Grouchy-Lawn-Chair/holomatrix-px/public/hardware/emt/head-23.5-assembled.stl

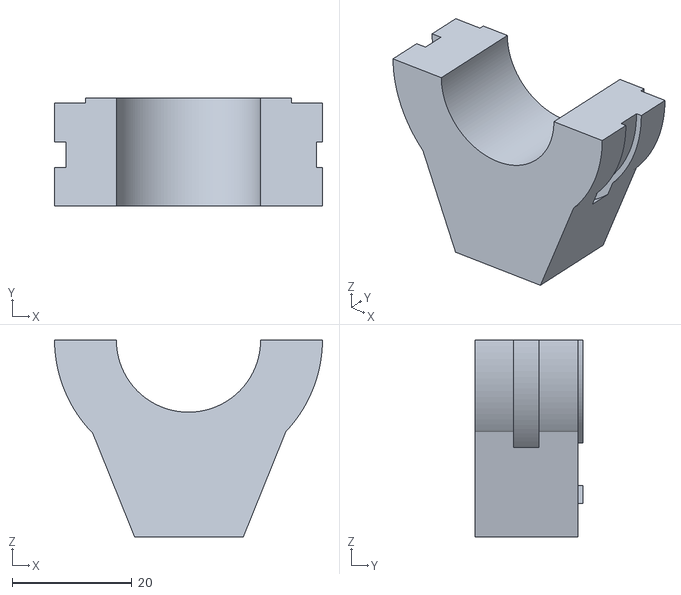
[picture p1: CAD file, 2026-10-11]
public/hardware/emt/head-23.5-assembled.stl
44.8 x 18.1 x 32.9
