Grouchy-Lawn-Chair/holomatrix-px/public/hardware/emt/base-assembled.stl

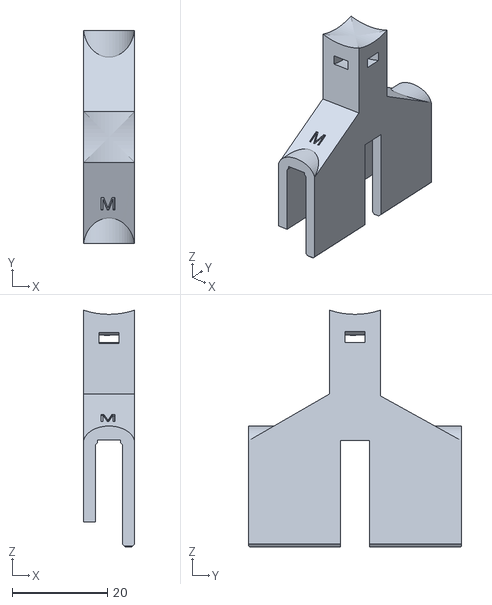
[picture p2: CAD file, 2026-10-11]
public/hardware/emt/base-assembled.stl
10.8 x 44.7 x 49.8
