Grouchy-Lawn-Chair/holomatrix-px/public/hardware/emt/head-21.336-assembled.stl

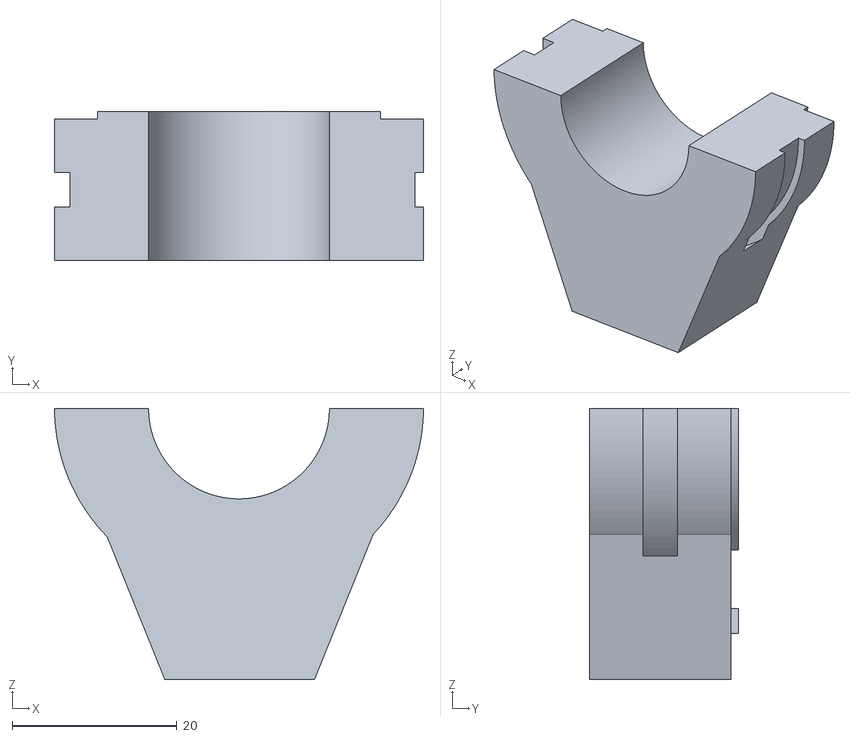
[picture p3: CAD file, 2026-10-11]
public/hardware/emt/head-21.336-assembled.stl
44.8 x 18.1 x 32.9
