Grouchy-Lawn-Chair/holomatrix-px/diffuser_references/pvc_house_clip.stl

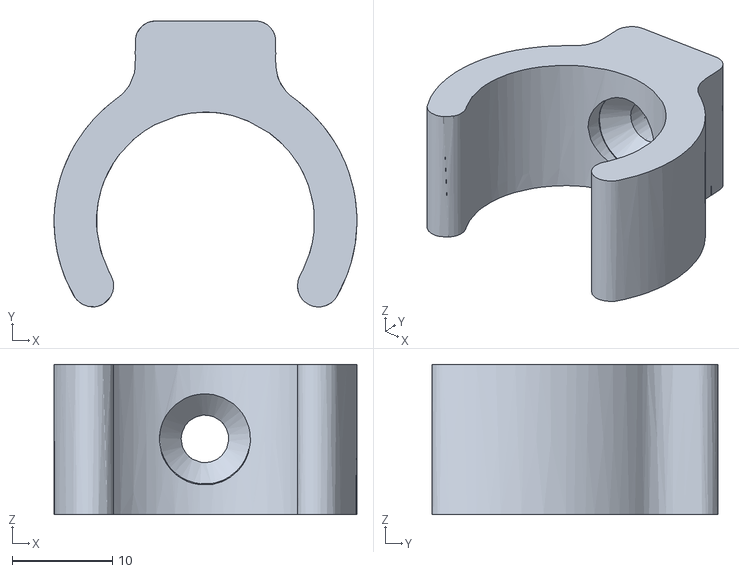
[picture p4: CAD file, 2026-10-11]
diffuser_references/pvc_house_clip.stl
30.2 x 28.5 x 15.0
