Grouchy-Lawn-Chair/holomatrix-px/diffuser_references/house_33mm.stl

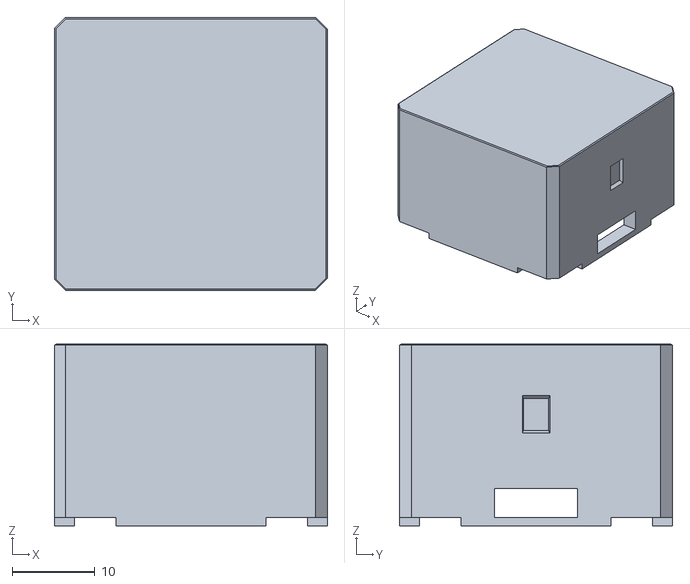
[picture p5: CAD file, 2026-10-11]
diffuser_references/house_33mm.stl
33.0 x 33.0 x 22.0
