Grouchy-Lawn-Chair/holomatrix-px/diffuser_references/mario_25_08mm.stl

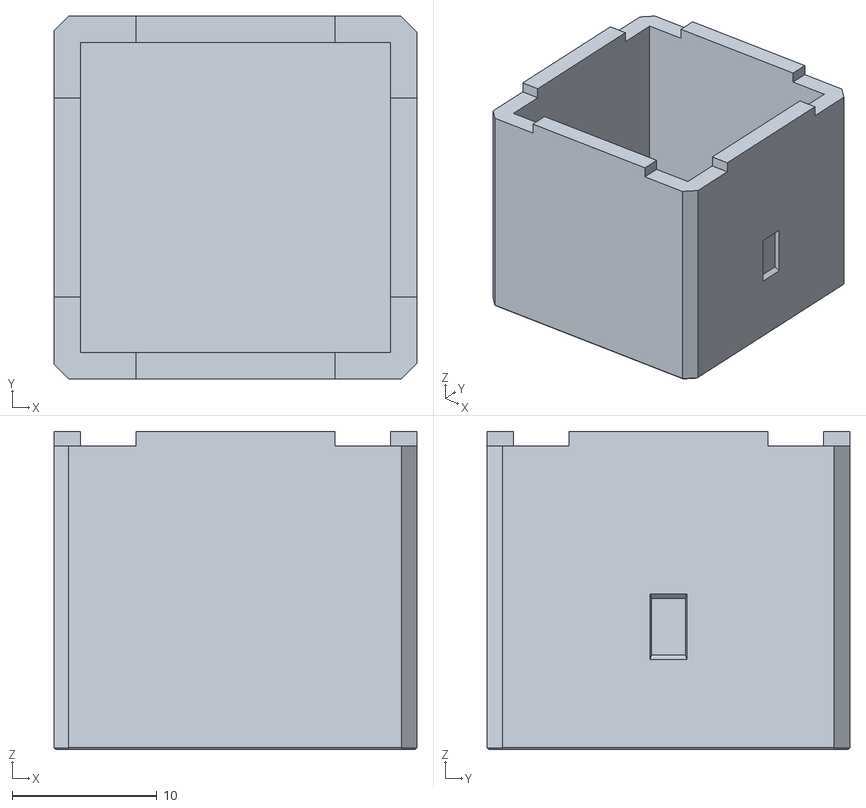
[picture p6: CAD file, 2026-10-11]
diffuser_references/mario_25_08mm.stl
25.1 x 25.1 x 22.0
