Grouchy-Lawn-Chair/holomatrix-px/(commit log)

2026-10-11 Launch HoloMatrix PX prop builder with GitHub Pages
    [base-assembled.stl, head-21.336-assembled.stl, head-23.5-assembled.stl, house_33mm.stl, mario_25_08mm.stl, pvc_house_clip.stl]
2026-10-11 Rebrand HoloProp Matrix with grounded holodeck and private prop library
2026-10-11 Ground prop independently of conduit planning guides
2026-10-12 Prevent holodeck surfaces from obscuring prop during camera orbit
2026-10-12 Guard bloom against invalid HDR samples that black out the viewport
2026-10-17 Route every prop as one data chain with explicit rear jumpers and splice estimates
